CalvEngIO/LiPoBatteryBreadboardSupply/Images/LiPoBatteryBreadboardSupply.jpg

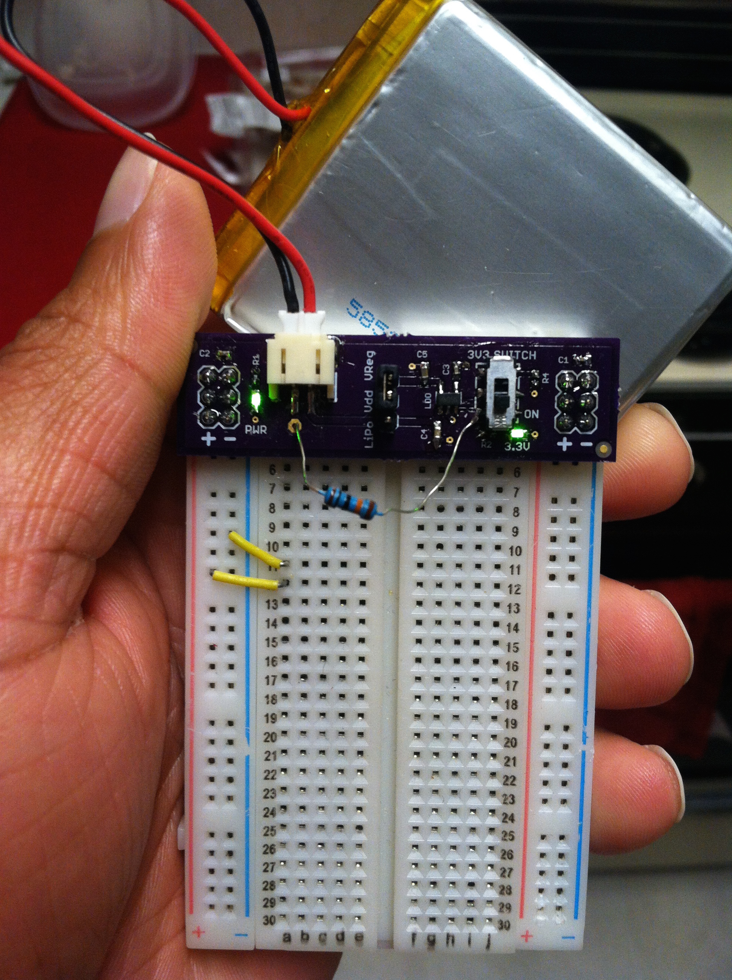
Images/LiPoBatteryBreadboardSupply.jpg
