CalvEngIO/LiPoBatteryBreadboardSupply/README.md

# LiPoBatteryBreadboardSupply
Breadboard power supply adapter for a Lithium Polymer Battery
