CalvEngIO/LiPoBatteryBreadboardSupply/Docs/LiPoBBSupply-BOM.xlsx

@CalvEngIO LiPo Battery Breadboard Supply Rev 0.3 |  |  |  |  |  |  |  |  |  |  | Total | $3.54
BOM # | Comment | Designator | Description | Mounting Type | Package | Manufacturer | Manufacturer Part Number | Supplier | Supplier Part Number | Price per unit | Quantity | Price Total
1 | JST Connector | LiPo | JST Right Angle Connector - White | SMD | NA | 4UCOM Technology Inc. |  | Sparkfun Electronics | PRT-08612 | $0.95 | 1 | $0.95
2 | AP2210 | LDO | Linear Voltage Regulator IC Positive Fixed 1 Output 3.3V 300mA SOT-23-5 | SMD | SOT-23-5 | Diodes Incorporated | AP2210K-3.3TRG1 | Digi-Key | AP2210K-3.3TRG1DICT-ND | $0.42 | 1 | $0.42
3 | Headers | J2,J3 | 15/40 Positions Header, Breakaway Connector 0.100" (2.54mm) Through Hole Gold | THT | THT | Sullins Connector Solutions | PRPC040SAAN-RC | Digi-Key | S1011EC-40-ND | $0.28 | 1 | $0.28
4 | 2.2uF cap | C1,C2,C3,C4 | 16V, X5R | SMD | 0603 | Murata Electronics North America | GRM188R61C225KE15D | Digi-Key | 490-3296-1-ND | $0.12 | 2 | $0.24
6 | 1k resistor | R1,R2 | RES SMD 1.02K OHM 1% 1/16W 0402 | SMD | 0402 | Yageo | RC0402FR-071K02L | Digi-Key | YAG3029CT-ND | $0.10 | 2 | $0.20
6 | 100k resistor | R3 | 100k Ohm ±1% 0.063W, 1/16W Chip Resistor 0402 (1005 Metric) Moisture Resistant Thick Film | SMD | 0402 | Yageo | RC0402FR-07100KL | Digi-Key | 311-100KLRCT-ND | $0.10 | 2 | $0.20
7 | Switch | 3V3.SWITCH | SWITCH SLIDE DPDT 300MA 6V | SMD | J Lead | C&K | JS202011JCQN | Digi-Key | CKN10723CT-ND | $0.48 | 1 | $0.48
8 | Shunt | J1 | 2 (1 x 2) Position Shunt Connector Black Open Top 0.100" (2.54mm) Gold | NA | NA | Sullins Connector Solutions | QPC02SXGN-RC | Digi-Key | S9337-ND | $0.13 | 1 | $0.13
9 | Green LED | 3.3V,PWR | Green 571 nm, 2 V | SMD | 0603 | Lite-On Inc | LTST-C190KGKT | Digi-Key | 160-1435-1-ND | $0.27 | 2 | $0.54
10 | 100pF | C5 | 100pF ±5% 50V Ceramic Capacitor C0G, NP0 0402 (1005 Metric) | SMD | 0402 | Samsung Electro-Mechanics America, Inc. | CL05C101JB5NNNC | Digi-Key | 1276-1025-1-ND | $0.10 | 1 | $0.10
