CalvEngIO/LiPoBatteryBreadboardSupply/Hardware/LiPoBatteryBreadboardSupply.brd

## EAGLE design Hardware/LiPoBatteryBreadboardSupply.brd (2017-05-08)

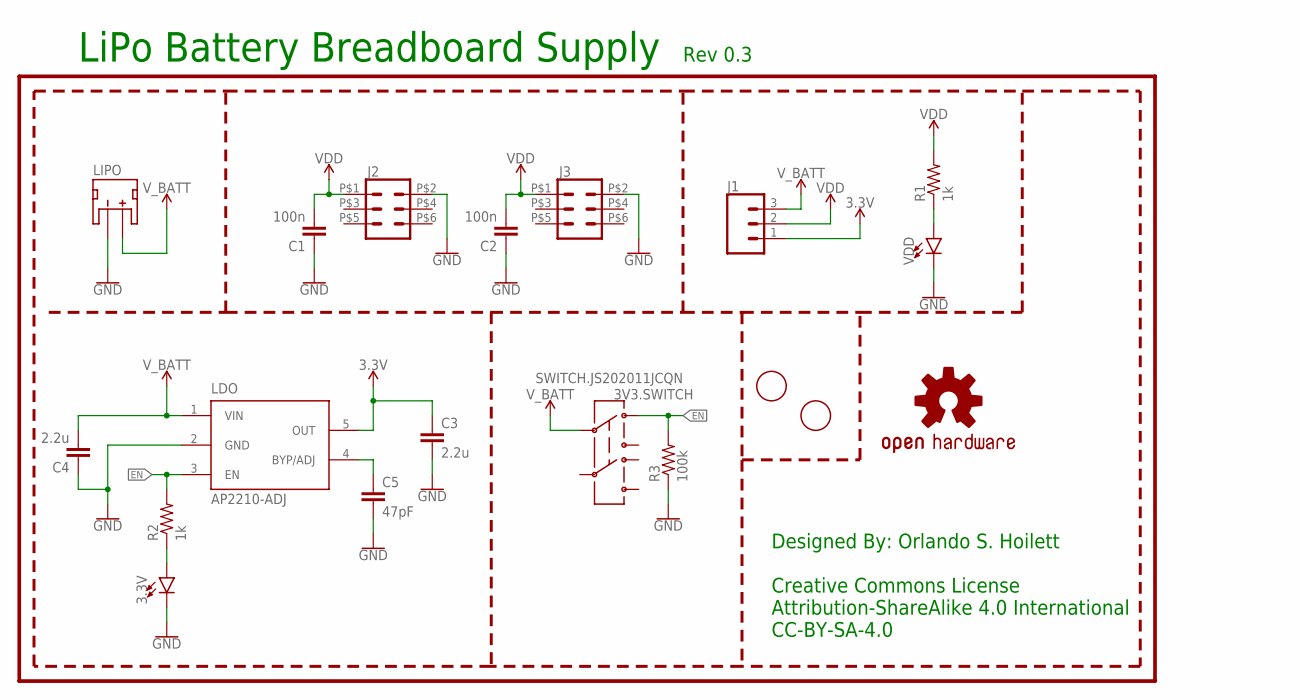
[picture p2: schematic LiPoBatteryBreadboardSupply.sch]

Parts:
3.3V: LED0603; LED-0603
3V3.SWITCH: SWITCH.JS202011JCQN; SWITCH.00
C1, C2: 100n; C0603
C3, C4: 2.2u; C0603
C5: 47pF; C0402
FD1, FD2: FIDUCIAL; FIDUCIAL_1MM
J1: CONN_03; 1X03
J2, J3: JMP.03X2HEADERS; JMP.03X2
LDO: AP2210-ADJ; SOT23-5
LIPO: JST_2MM_MALE; JST-2-SMD
LOGO1: OSHW-LOGOS; OSHW-LOGO-S
R1, R2: 1k; R0402
R3: 100k; R0402
U$1: HANDLE.1HANDLE.025; HANDLE.025
U$6: HANDLE.1HANDLE.08; HANDLE.08
VDD: LED0603; LED-0603

Connections:
3.3V: C3.1, J1.1, LDO.5 (OUT)
EN: 3V3.SWITCH.1, LDO.3 (EN), R2.2, R3.2
GND: 3.3V.C, C1.1, C2.1, C3.2, C4.1, C5.2, J2.P$2 (2), J3.P$2 (2), LDO.2 (GND), LIPO.1 (-), R3.1, VDD.C
unnamed: 3.3V.A, R2.1
unnamed: R1.1, VDD.A
unnamed: C5.1, LDO.4 (BYP/ADJ)
VDD: C1.2, C2.2, J1.2, J2.P$1 (1), J3.P$1 (1), R1.2
V_BATT: 3V3.SWITCH.2, C4.2, J1.3, LDO.1 (VIN), LIPO.2 (+)

Notes on the sheet:
Creative Commons License Attribution-ShareAlike 4.0 International CC-BY-SA-4.0
Designed By: Orlando S. Hoilett
LiPo Battery Breadboard Supply
Rev 0.3

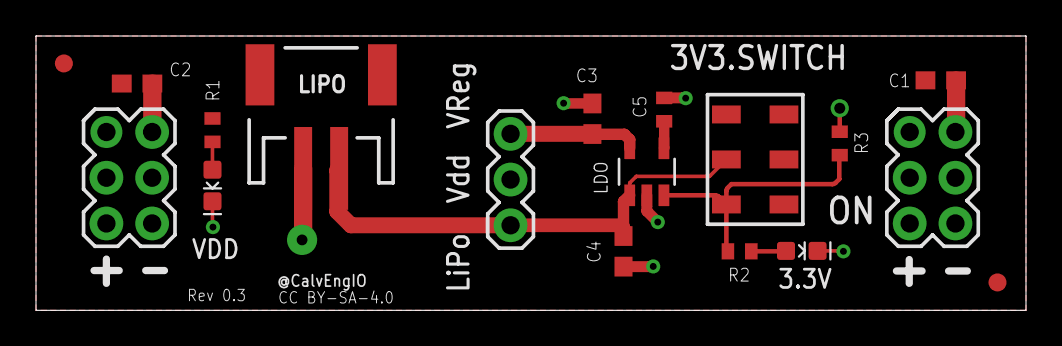
[picture p3: board LiPoBatteryBreadboardSupply.brd from above]

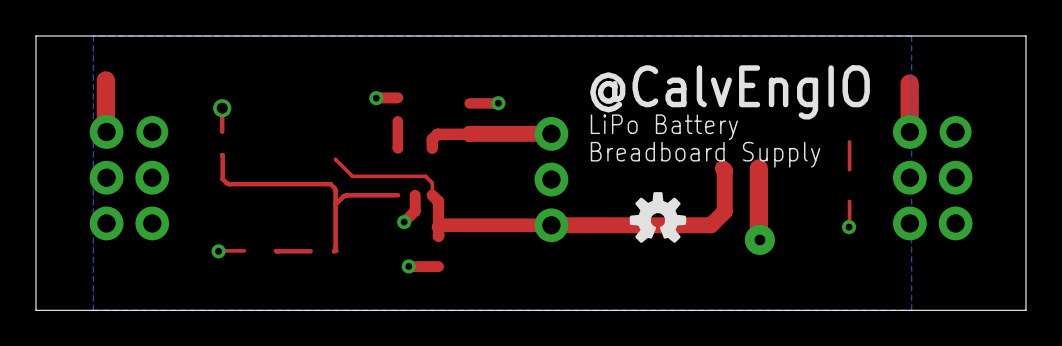
[picture p4: board LiPoBatteryBreadboardSupply.brd from below]

Board: 2 copper layers, 55.0 x 15.2 mm, 21 parts (2 on the bottom side), 8 nets.
