CalvEngIO/LiPoBatteryBreadboardSupply/(commit log)

2017-03-02 inital commit, very incomplete and untested
    [LiPoBBSupply-BOM.xlsx, LiPoBatteryBreadboardSupply.brd, LiPoBatteryBreadboardSupply.sch]
2017-03-02 more edits, need tons of editing
    [LiPoBBSupply-BOM.xlsx]
2017-05-08 changes to the silkscreen and changes to the BOM
    [LiPoBBSupply-BOM.xlsx, LiPoBatteryBreadboardSupply.brd, LiPoBatteryBreadboardSupply.sch]
2017-05-08 changes to BOM and change in value of Cbypass on regulator in schematic
    [LiPoBBSupply-BOM.xlsx, LiPoBatteryBreadboardSupply.brd, LiPoBatteryBreadboardSupply.sch]
2017-07-28 more updates
    [LiPoBBSupply-BOM.xlsx, LiPoBatteryBreadboardSupply.sch]
